nullvalue0/BreakawayMod/enclosure/duke-pack-cradle.stl

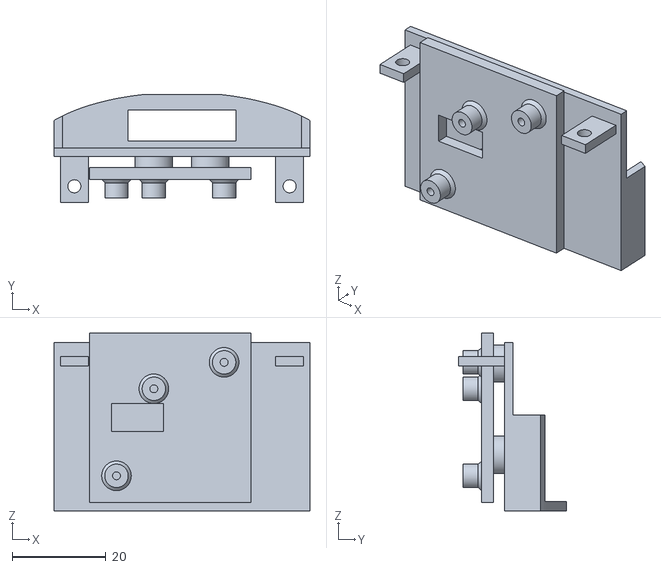
[picture p1: CAD file, 2026-10-13]
enclosure/duke-pack-cradle.stl
54.7 x 23.1 x 38.0
