nullvalue0/BreakawayMod/enclosure/controller-s-pack-body.stl

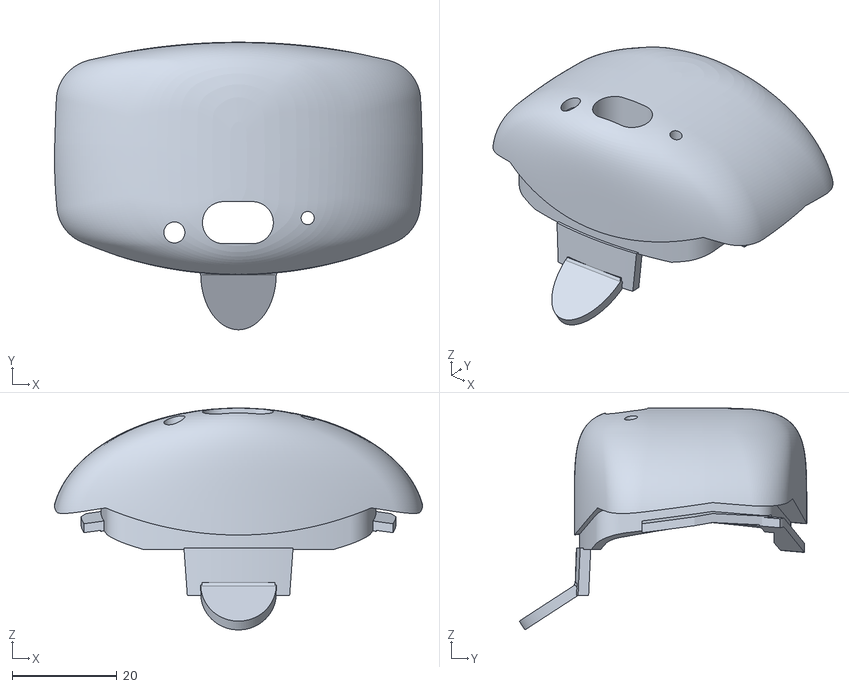
[picture p2: CAD file, 2026-10-13]
enclosure/controller-s-pack-body.stl
70.1 x 54.8 x 42.3
