nullvalue0/BreakawayMod/enclosure/duke-pack-body.stl

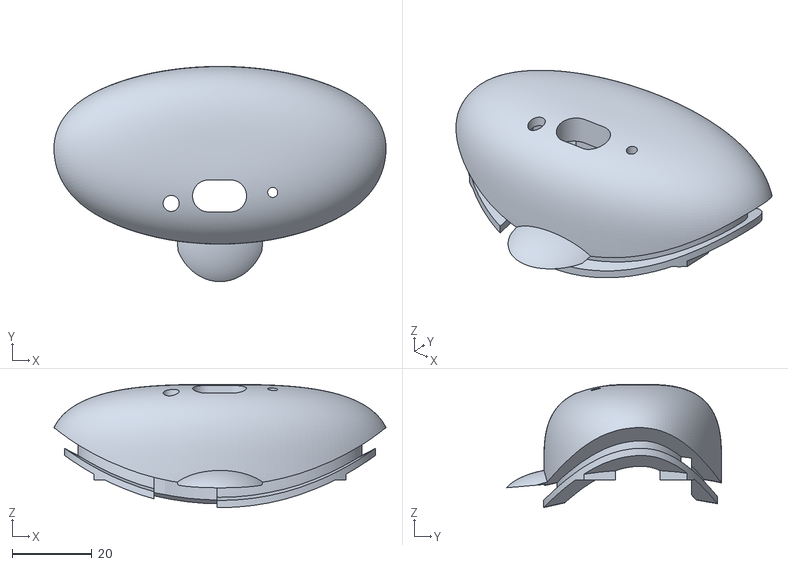
[picture p3: CAD file, 2026-10-13]
enclosure/duke-pack-body.stl
83.1 x 53.9 x 30.9
