nullvalue0/BreakawayMod/enclosure/controller-s-pack-cradle.stl

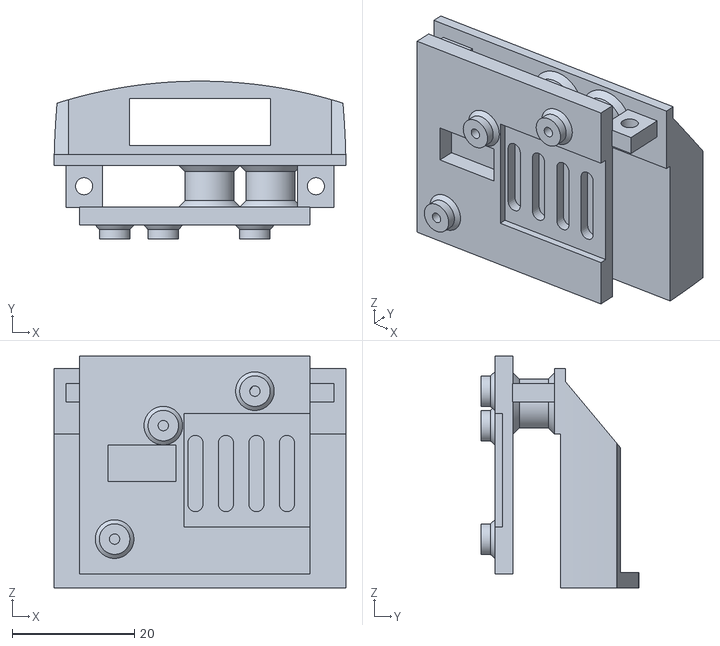
[picture p4: CAD file, 2026-10-13]
enclosure/controller-s-pack-cradle.stl
47.9 x 25.8 x 38.0
